Norman-w/therapy-cable-inline-box-for-physio/docs/synairy-esc-adaptor-v02/README.md

# Synairy ESC-Adaptor V02（扩展输入版）

v2 方案所用直流电机 / 电调 PWM 调速信号板。资料来源见 [`images/`](images/)。

插针（`SIG` / `VIN` / `GND`）装配前拆除，改焊线引出。

**完整尺寸表（PCB / 开孔 / 壳体）→ [`dimensions.md`](dimensions.md)**

## 尺寸速查

| 项目 | 数值 |
|---|---|
| PCB | **31.5 × 12 × 1.6 mm**（复测） |
| 自左向右 | 轴 **10~15**；数码管 **18.5~27**；均板宽居中 |
| 数码管外形 | **8.5 × 12**（长边 12） |
| 轴孔 / 腔内柱高 | 壳 ⌀**8.0**；腔内净高 **7.5 mm**（帽壳外再装） |
| 开关 | **不开孔** |
| 安装孔 | 短边内缩 **1.5** / 长边 **2.0**；孔心距 ΔX **28.5**；板心 (±14.25, ±4.0) |
| 壳体内腔 | **70 × 30 × 15 mm**；底面 4×M2 合盖（顶面无螺孔）+ 内 2×罗马柱 |

## 接口

| 丝印 | 含义 |
|---|---|
| `SIG` | PWM 信号输出 |
| `VIN` | 供电正极 |
| `GND` | 地 |

板底另有焊盘：`VDD` / `IN` / `GND`（扩展输入）。

## 电气与 PWM

| 项目 | 规格 |
|---|---|
| 工作电压 | DC **3–24 V** |
| 接口 | 3P：供电 + PWM 输出 |
| 显示 | 数码管，转速百分比 |
| 伺服 / 无刷电调模式 PWM 频率 | **50 Hz**（固定） |
| 脉宽调节范围 | **0.95 ms – 1.95 ms** |

## 操作与模式

板载：黄色旋钮调速；轻触键用于开关启动（见 [`images/03.webp`](images/03.webp)）。

焊盘短接模式见 [`images/02.webp`](images/02.webp)：

| 模式 | 配置 | 行为 |
|---|---|---|
| 默认模式 | 焊盘空置 | 旋钮直接调速 |
| 上电启动 | 短接「上电启动」 | 上电约 3 s 后爬升到设定转速 |
| 开关启动 | 短接「开关启动」 | 需按住按键/闭合开关才运转 |

## 资料索引

| 文件 | 内容 |
|---|---|
| [`images/01.webp`](images/01.webp) | 外观 + 参数表 |
| [`images/02.webp`](images/02.webp) | 模式焊盘说明 |
| [`images/03.webp`](images/03.webp) | 开关启动按键 |
| [`images/04.webp`](images/04.webp) | PCB **32×12 mm** |
