Norman-w/therapy-cable-inline-box-for-physio/docs/synairy-esc-adaptor-v02/images/02.webp

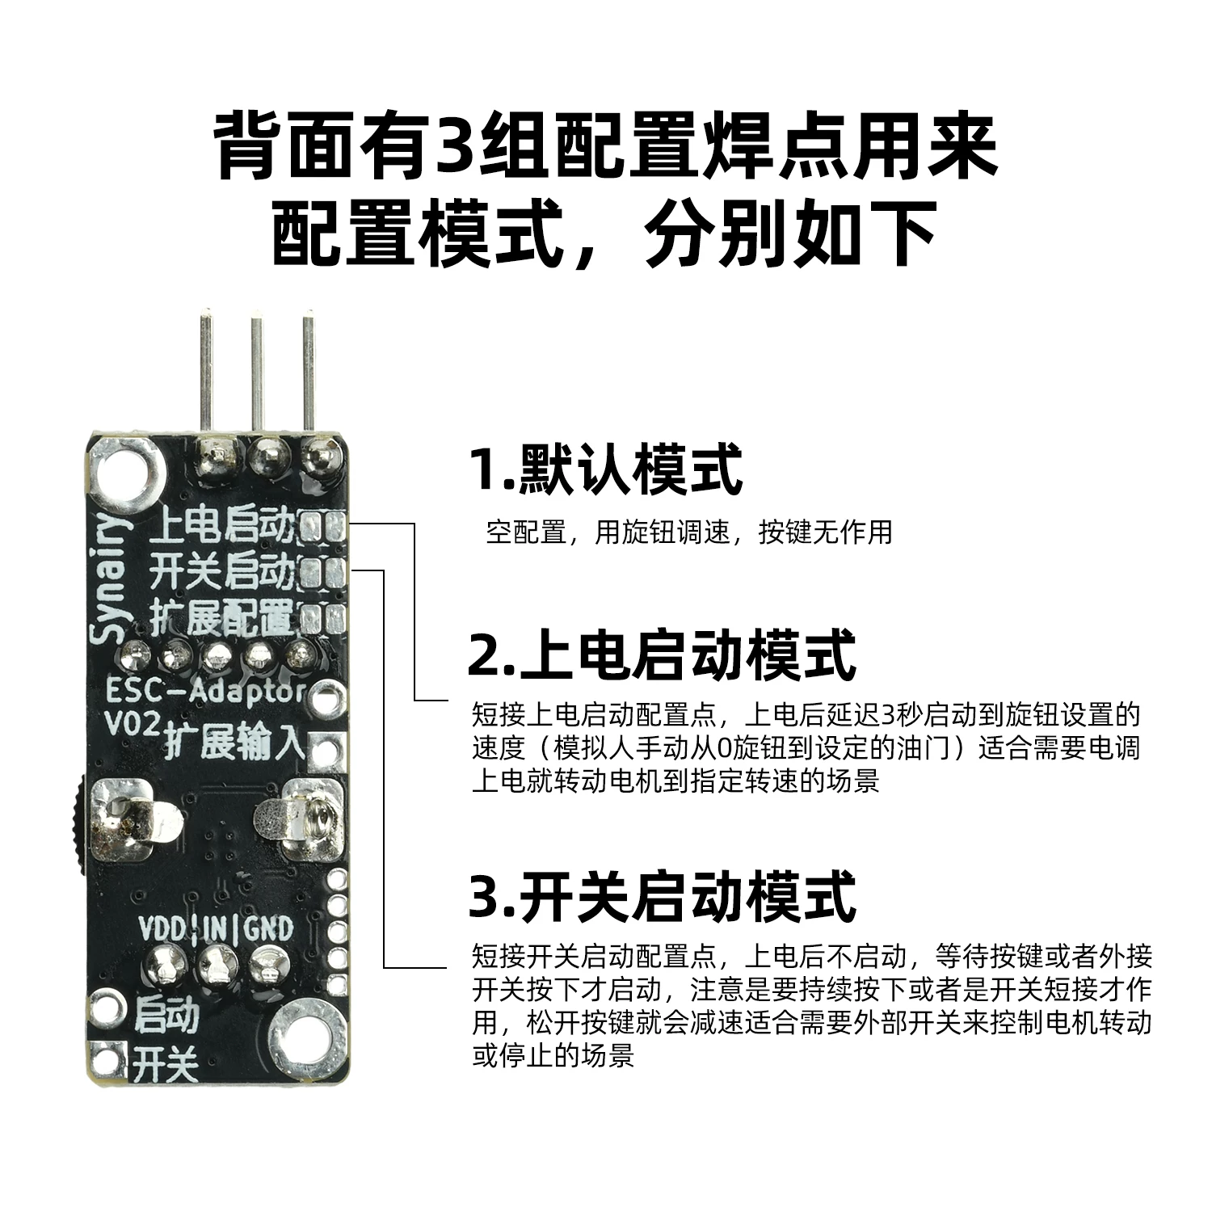
docs/synairy-esc-adaptor-v02/images/02.webp
