Norman-w/therapy-cable-inline-box-for-physio/docs/synairy-esc-adaptor-v02/images/04.webp

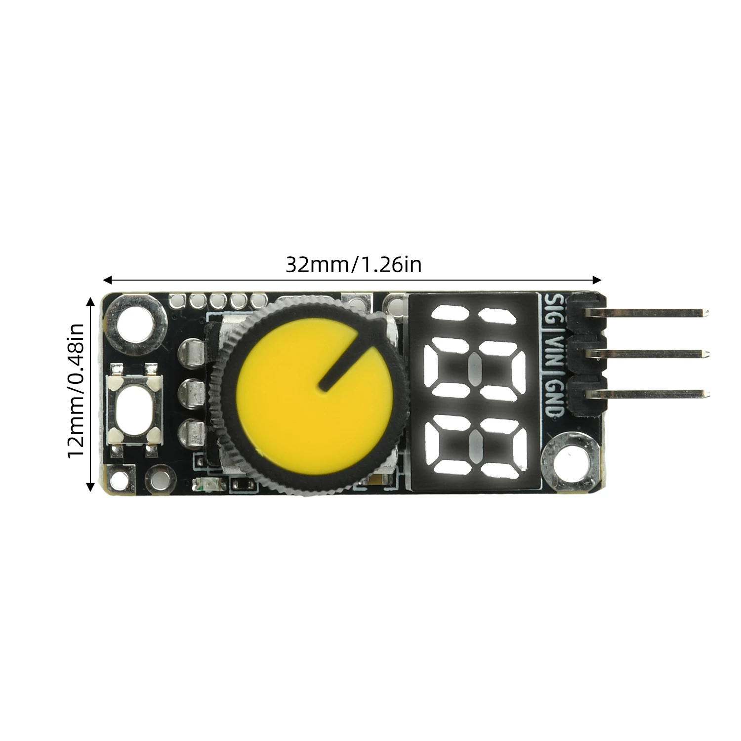
docs/synairy-esc-adaptor-v02/images/04.webp
