Norman-w/therapy-cable-inline-box-for-physio/(commit log)

2026-07-08 🧊 理疗仪线缆串联电阻保护盒 — 初始版本
    - OpenSCAD 参数化建模，上下两半壳体螺丝对接
    - M2 自攻螺丝 ×4，Boss 柱 Φ5 锥形加固根部
    - 矩形电阻型腔 9×9×22mm，5mm 线缆压紧通道
    - 8 角全圆角 R3，FDM 打印优化
    - Three.js WebGL 3D 预览页 + STL 下载
    [bottom-half.scad, cable-gland.scad, main.scad, parameters.scad, resistor-holder.scad, top-half.scad, utilities.scad]
2026-07-08 🪢 添加线缆 S 型绕柱加固
    - 每组 2 根挡柱，错开 ±3mm，间距 8mm
    - 强制线缆走 S 弯，防止外力拉扯焊点
    - 装在下半壳体，伸出分型面 3mm
    [bottom-half.scad, cable-strain-relief.scad, main.scad]
2026-07-08 📐 线缆挡柱改为矩形截面
    - 2.5×5mm 矩形柱，比圆形更有效阻挡线缆
    - 装在下半壳体，凸出分型面 5mm
    - 强制线缆 S 型绕行，吸收外力拉扯
    [cable-strain-relief.scad]
2026-07-08 📐 重做线缆挡柱 — 4×8mm 大截面矩形
    - 柱A在Y=+4, 柱B在Y=-4, 形成S弯
    - 从底板伸到分型面以上5mm
    - Boss柱X移到17, 避免与挡柱重叠
    [cable-strain-relief.scad, parameters.scad]
2026-07-08 🔧 三项修改：简化出线孔 + 挡柱中轴排列 + 根部加固
    - 出线孔简化为 Φ5.4 通孔，仅壁厚+1mm延伸，不打到内部结构
    - 4根挡柱全部移到中轴线 Y=0，宽3×厚4mm
    - 挡柱根部阶梯加宽(6×7mm底座，3mm高)
    - 线缆S弯：柱A(近入口)→柱B(靠内)→交替绕行
    [cable-gland.scad, cable-strain-relief.scad, parameters.scad]
2026-07-08 🔧 重构下半壳体结构：挡柱不受电阻腔切割
    - 先切电阻腔 → 再加Boss柱+挡柱 → 最后切线缆孔
    - 挡柱在中轴线Y=0，3×4mm截面，6×7mm根部加固
    - 出线孔简化为Φ5.4通孔
    [bottom-half.scad]
2026-07-08 🧹 去掉电阻腔 + 去掉挡柱加粗底座
    [bottom-half.scad, cable-strain-relief.scad, top-half.scad]
2026-07-08 🔧 挡柱与分型面齐平，不再凸出
    [cable-strain-relief.scad]
2026-07-08 🔄 STL URL 加时间戳破浏览器缓存
2026-07-08 🔧 出线孔向内加深 0.5mm
    [parameters.scad]
2026-07-08 ↔️ 挡柱A向腔体中心挪5mm
    [cable-strain-relief.scad]
2026-07-08 🦷 线缆约束改为锯齿压紧方案
    - 去掉矩形挡柱，改为每端3道三角锯齿
    - 下半齿尖向上，上半齿尖向下
    - 螺丝拧紧时上下齿对咬，压紧线缆
    - 立面朝内、斜面朝外，防拉脱
    [bottom-half.scad, cable-strain-relief.scad, top-half.scad]
2026-07-08 🔧 锯齿从壳壁延伸到齿尖，不再悬空
    [cable-strain-relief.scad]
2026-07-08 💡 提亮3D预览灯光 + 🔧 锯齿对称梯形平顶
    - 环境光 3.5x, 新增底部补光消阴影
    - 锯齿梯形平顶1.5mm, 上下间隙4mm夹紧5mm线缆
    - 修正镜像逻辑, 两侧齿对称
    [cable-strain-relief.scad]
2026-07-08 🔧 锯齿改用 hull 方式，保证水密
    [cable-strain-relief.scad]
2026-07-08 🔧 修正上半锯齿方向：齿尖朝分型面
    [cable-strain-relief.scad]
2026-07-08 🦷 下半减为2齿 + 偏移半齿距 → 3包2交错咬合
    [cable-strain-relief.scad]
2026-07-08 📌 上半壳加线缆夹持柱 — 内齿旁4柱夹住线缆
    [cable-strain-relief.scad, top-half.scad]
2026-07-08 📏 夹持柱X移到±13, 间隙26mm放22mm电阻
    [cable-strain-relief.scad]
2026-07-08 📏 夹持柱移到X=±21, 齿间避开Boss柱
    [cable-strain-relief.scad]
2026-07-08 📏 夹持柱X=±11.5紧贴最内齿, 2mm窄柱减少冲突
    [cable-strain-relief.scad]
2026-07-08 🔧 第一齿内移1mm, 齿底不超出外壳
    [cable-strain-relief.scad]
2026-07-08 📏 夹持柱远心端与最内齿立面(X=14)平齐
    [cable-strain-relief.scad]
2026-07-08 📏 夹持柱双侧远心端均与最内齿立面平齐
    [cable-strain-relief.scad]
2026-07-08 🔧 夹持柱根部加宽加固(5×5底座, 高3mm)
    [cable-strain-relief.scad]
2026-07-08 🔧 夹持柱加固翻转到靠壳体顶壁侧
    [cable-strain-relief.scad]
2026-07-08 🔺 夹持柱加固改为四棱锥台
    [cable-strain-relief.scad]
2026-07-08 ✨ 上包下外包围 + Boss端面间隙 + 网页改版
    - 上半外壁裙边包裹下半 2mm, 壁厚各0.8mm
    - Boss柱上下各缩减0.5mm, 防螺丝挤压凸起
    - 网页去掉拖拽, 下载面板独立, 新增合并预览+合并打印STL
    [bottom-half.scad, main.scad, parameters.scad, top-half.scad]
2026-07-08 🔧 回滚复杂包围设计，保留Boss间隙+网页改版
    - 移除有问题的上包下重叠结构
    - Boss柱上下各留0.5mm端面间隙
    - 网页: 去掉拖拽, 下载面板独立, 合并预览+合并打印STL
    [bottom-half.scad, top-half.scad]
2026-07-08 🔒 加内衬密封圈: 1mm壁厚, 各伸2mm桥接上下壳
    [bottom-half.scad, parameters.scad]
2026-07-08 🔒 内衬嵌入壳壁1mm，内面齐平，不挡柱子
    [bottom-half.scad, top-half.scad]
2026-07-08 ⏪ 回退SCAD到b447667 + 保留网页改版和flat导出
    [bottom-half.scad, parameters.scad, top-half.scad]
2026-07-08 🔧 Boss柱上下各缩短0.5mm, 分型面留1mm缝隙
    [bottom-half.scad, parameters.scad, top-half.scad]
2026-07-08 🔧 Boss柱各缩0.5mm留缝隙
2026-07-08 📐 加宽5mm加长10mm (内腔60×25)
    [cable-strain-relief.scad, parameters.scad]
2026-07-08 🔧 三尺两齿换面 + 夹持柱移下半 + 加固靠底板
    [bottom-half.scad, cable-strain-relief.scad, top-half.scad]
2026-07-08 🔧 Boss柱间隙改在分型面端, 壳壁端齐平让沉头孔打通
    [bottom-half.scad, top-half.scad]
2026-07-08 📏 Boss端面间隙从1mm缩到0.5mm
    [bottom-half.scad, top-half.scad]
2026-07-08 📏 下半Boss取消间隙，仅上半留0.25mm
    [bottom-half.scad]
2026-07-23 📝 标注v2改用调速器，并整理ESC模组尺寸资料
2026-07-24 🎛️ 壳体改为v2调速器布局，按实测开窗并加长避让立柱
    [bottom-half.scad, main.scad, module-holder.scad, parameters.scad, resistor-holder.scad, top-half.scad]
2026-07-24 📐 将v2开孔与壳体尺寸写入dimensions文档
2026-07-24 📚 根README链到dimensions尺寸文档
2026-07-24 📏 安装孔改距角1.5mm，旋钮开孔加大到6.5以利打印装配
    [parameters.scad]
2026-07-24 📦 内腔加宽到30mm便于接线，合盖螺丝改底面使正面只露旋钮与数码
    [bottom-half.scad, parameters.scad, top-half.scad]
